kawashimaken/smartknob/electronics/motor_driver_tmc6300/motor_driver_tmc6300.kicad_pcb

## KiCad design electronics/motor_driver_tmc6300/motor_driver_tmc6300.kicad_pcb (2024-10-07)

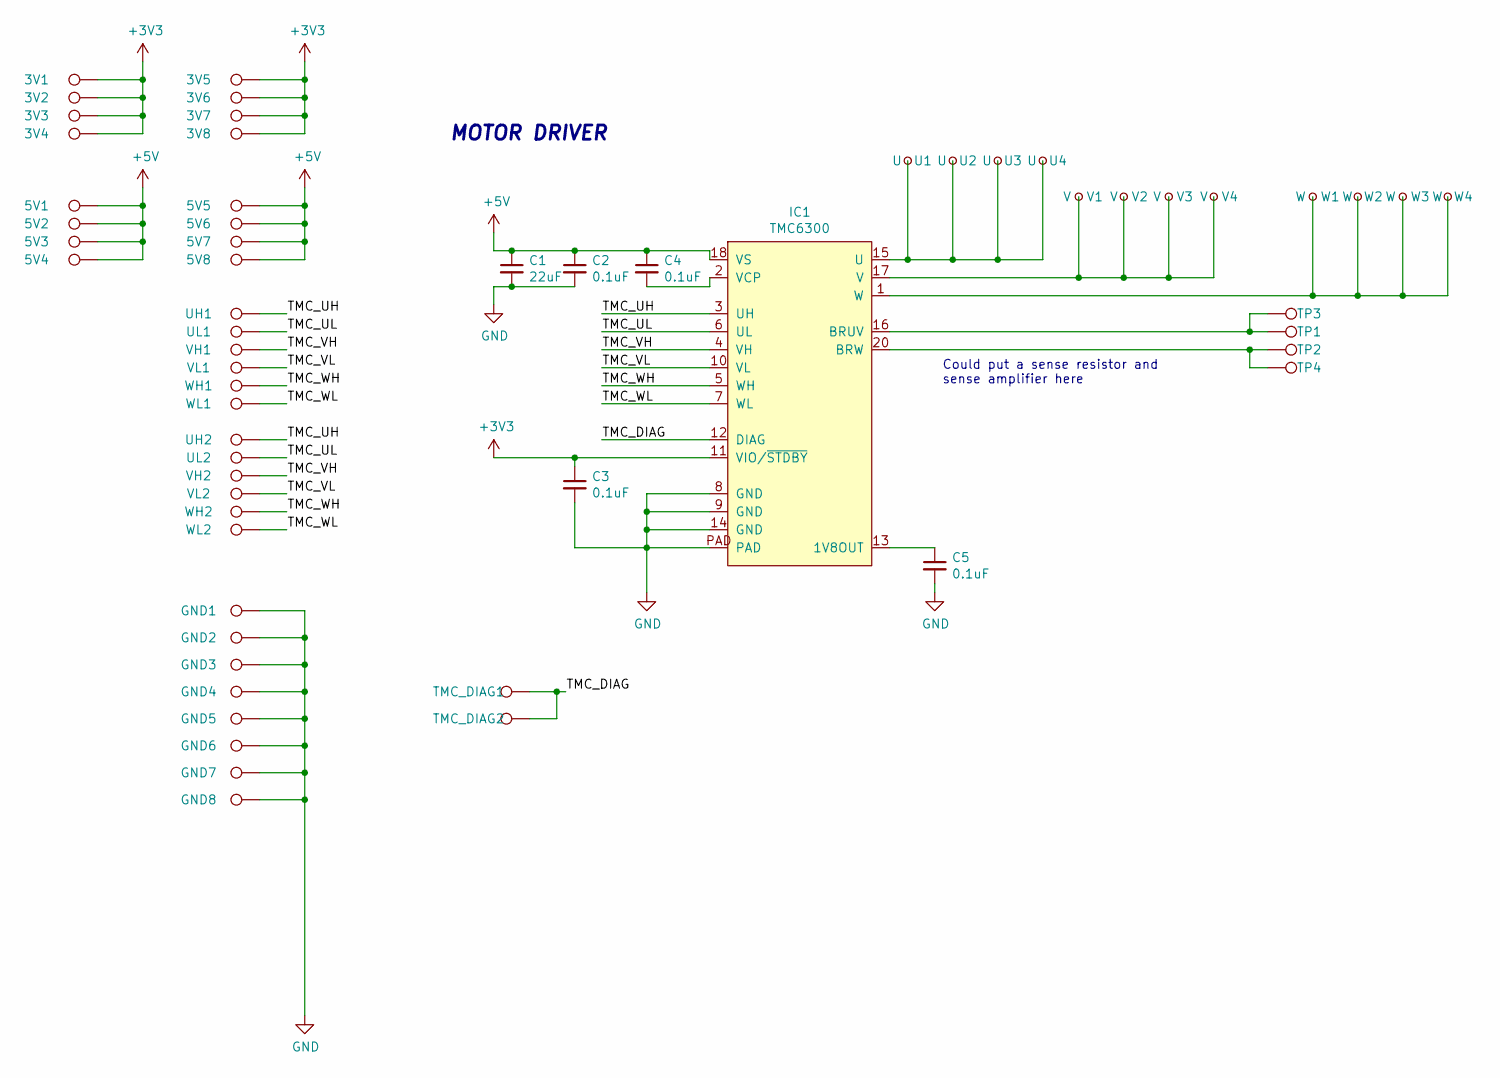
[picture p1: schematic motor_driver_tmc6300.kicad_sch, SmartKnob View]

Parts:
3V1, 3V2, 3V3, 3V4, 3V5, 3V6, 3V7, 3V8, 5V1, 5V2, 5V3, 5V4, 5V5, 5V6, 5V7, 5V8: TestPoint; kawashima_TestPoint_THTPad_D1.5mm_Drill0.7mm
C1: 22uF; C_0805_2012Metric_Pad1.18x1.45mm_HandSolder; LCSC C98190
C2, C3, C4, C5: 0.1uF; C_0603_1608Metric_Pad1.08x0.95mm_HandSolder; LCSC C1591
GND1, GND2, GND3, GND4, GND5, GND6, GND7, GND8: TestPoint; kawashima_TestPoint_THTPad_D1.5mm_Drill0.7mm
IC1: TMC6300; QFN-20-1EP_3x3mm_P0.4mm_EP1.65x1.65mm_ThermalVias_LargerVia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; Digikey TMC6300-LA-T
TMC_DIAG1, TMC_DIAG2: TestPoint; kawashima_TestPoint_THTPad_D1.5mm_Drill0.7mm
TP1, TP2, TP3, TP4: TestPoint; kawashima_TestPoint_THTPad_D1.5mm_Drill0.7mm
U1, U2, U3, U4: U; kawashima_TestPoint_THTPad_D1.5mm_Drill0.7mm
UH1, UH2: TestPoint; kawashima_TestPoint_THTPad_D1.5mm_Drill0.7mm
UL1, UL2: TestPoint; kawashima_TestPoint_THTPad_D1.5mm_Drill0.7mm
V1, V2, V3, V4: V; kawashima_TestPoint_THTPad_D1.5mm_Drill0.7mm
VH1, VH2: TestPoint; kawashima_TestPoint_THTPad_D1.5mm_Drill0.7mm
VL1, VL2: TestPoint; kawashima_TestPoint_THTPad_D1.5mm_Drill0.7mm
W1, W2, W3, W4: W; kawashima_TestPoint_THTPad_D1.5mm_Drill0.7mm
WH1, WH2: TestPoint; kawashima_TestPoint_THTPad_D1.5mm_Drill0.7mm
WL1, WL2: TestPoint; kawashima_TestPoint_THTPad_D1.5mm_Drill0.7mm

Connections:
+3V3: 3V1.1, 3V2.1, 3V3.1, 3V4.1, 3V5.1, 3V6.1, 3V7.1, 3V8.1, C3.1, IC1.11 (VIO/~STDBY)
+5V: 5V1.1, 5V2.1, 5V3.1, 5V4.1, 5V5.1, 5V6.1, 5V7.1, 5V8.1, C1.1, C2.1, C4.1, IC1.18 (VS)
/TMC_DIAG: IC1.12 (DIAG), TMC_DIAG1.1, TMC_DIAG2.1
/TMC_UH: IC1.3 (UH), UH1.1, UH2.1
/TMC_UL: IC1.6 (UL), UL1.1, UL2.1
/TMC_VH: IC1.4 (VH), VH1.1, VH2.1
/TMC_VL: IC1.10 (VL), VL1.1, VL2.1
/TMC_WH: IC1.5 (WH), WH1.1, WH2.1
/TMC_WL: IC1.7 (WL), WL1.1, WL2.1
GND: C1.2, C2.2, C3.2, C5.2, GND1.1, GND2.1, GND3.1, GND4.1, GND5.1, GND6.1, GND7.1, GND8.1, IC1.8 (GND), IC1.9 (GND), IC1.14 (GND), IC1.PAD
unnamed: C5.1, IC1.13 (1V8OUT)
unnamed: IC1.16 (BRUV), TP1.1, TP3.1
unnamed: IC1.20 (BRW), TP2.1, TP4.1
unnamed: IC1.15 (U), U1.1, U2.1, U3.1, U4.1
unnamed: IC1.17 (V), V1.1, V2.1, V3.1, V4.1
unnamed: C4.2, IC1.2 (VCP)
unnamed: IC1.1 (W), W1.1, W2.1, W3.1, W4.1

Notes on the sheet:
Could put a sense resistor and sense amplifier here
MOTOR DRIVER

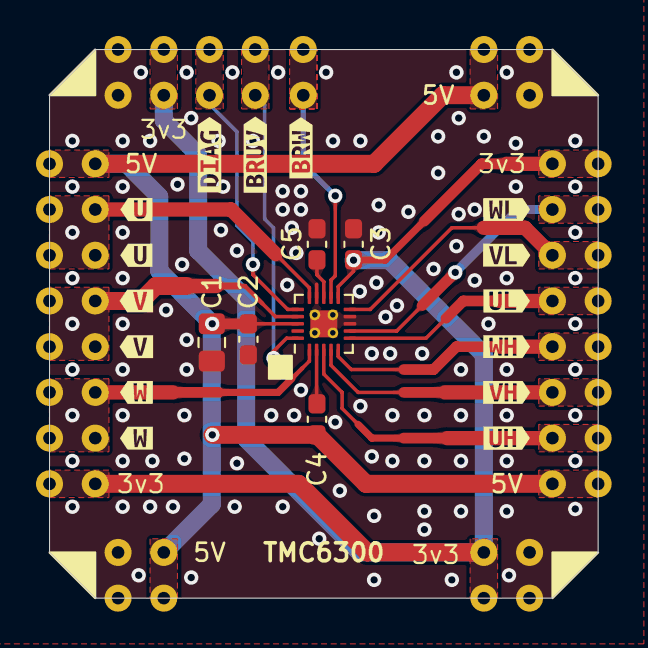
[picture p2: board motor_driver_tmc6300.kicad_pcb from above]

Board: 2 copper layers, 30.5 x 30.5 mm, 75 parts (0 on the bottom side), 17 nets.

Other parts of the board:
kibuzzard-6701E86E, kibuzzard-6701E86E#2: G***; kibuzzard-6701E86E
kibuzzard-6701E87B, kibuzzard-6701E87B#2: G***; kibuzzard-6701E87B
kibuzzard-6701E882, kibuzzard-6701E882#2: G***; kibuzzard-6701E882
kibuzzard-670234D9: G***; kibuzzard-670234D9
kibuzzard-6702202C: G***; kibuzzard-6702202C
kibuzzard-6702204D: G***; kibuzzard-6702204D
kibuzzard-6702206A: G***; kibuzzard-6702206A
kibuzzard-67022038: G***; kibuzzard-67022038
kibuzzard-67022043: G***; kibuzzard-67022043
kibuzzard-67022085: G***; kibuzzard-67022085
kibuzzard-67032619: G***; kibuzzard-67032619
kibuzzard-67032626: G***; kibuzzard-67032626
