kawashimaken/smartknob/electronics/motor_driver_tmc6300/motor_driver_tmc6300-rounded.kicad_pcb

## KiCad design electronics/motor_driver_tmc6300/motor_driver_tmc6300-rounded.kicad_pcb (2024-10-06)

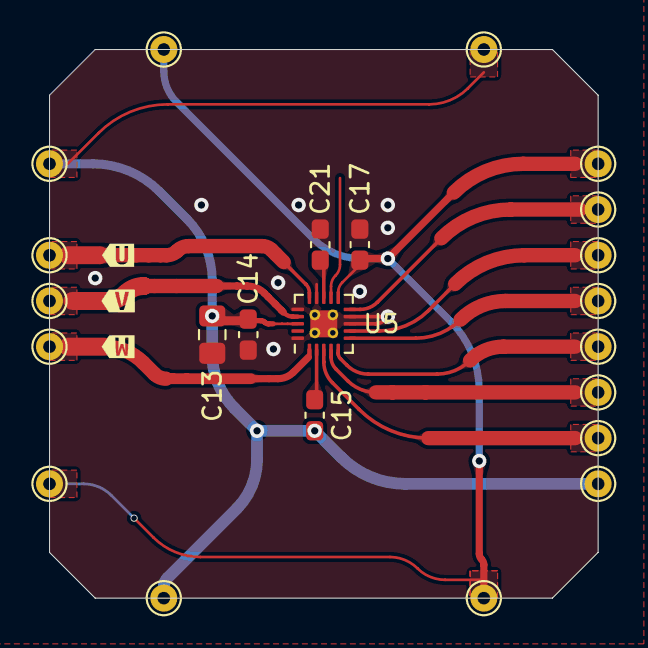
[picture p6: board motor_driver_tmc6300-rounded.kicad_pcb from above]

Board: 2 copper layers, 30.5 x 30.5 mm, 26 parts (0 on the bottom side), 14 nets.

Parts:
3V1, 3V2, 3V3, 3V4, 5V1, 5V2, 5V3, 5V4: TestPoint; TestPoint_THTPad_D1.5mm_Drill0.7mm
C13: 22uF; C_0805_2012Metric_Pad1.18x1.45mm_HandSolder
C14, C15, C17, C21: 0.1uF; C_0603_1608Metric_Pad1.08x0.95mm_HandSolder
U1: U; TestPoint_THTPad_D1.5mm_Drill0.7mm
U5: TMC6300; QFN-20-1EP_3x3mm_P0.4mm_EP1.65x1.65mm_ThermalVias_LargerVia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
UH1: TestPoint; TestPoint_THTPad_D1.5mm_Drill0.7mm
UL1: TestPoint; TestPoint_THTPad_D1.5mm_Drill0.7mm
V1: V; TestPoint_THTPad_D1.5mm_Drill0.7mm
VH1: TestPoint; TestPoint_THTPad_D1.5mm_Drill0.7mm
VL1: TestPoint; TestPoint_THTPad_D1.5mm_Drill0.7mm
W1: W; TestPoint_THTPad_D1.5mm_Drill0.7mm
WH1: TestPoint; TestPoint_THTPad_D1.5mm_Drill0.7mm
WL1: TestPoint; TestPoint_THTPad_D1.5mm_Drill0.7mm
kibuzzard-6701E86E: G***; kibuzzard-6701E86E
kibuzzard-6701E87B: G***; kibuzzard-6701E87B
kibuzzard-6701E882: G***; kibuzzard-6701E882

Connections:
+3V3: 3V1.1, 3V2.1, 3V3.1, 3V4.1, C17.1, U5.11 (VIO/~STDBY)
+5V: 5V1.1, 5V2.1, 5V3.1, 5V4.1, C13.1, C14.1, C15.1, U5.18 (VS)
/TMC_UH: U5.3 (UH), UH1.1
/TMC_UL: U5.6 (UL), UL1.1
/TMC_VH: U5.4 (VH), VH1.1
/TMC_VL: U5.10 (VL), VL1.1
/TMC_WH: U5.5 (WH), WH1.1
/TMC_WL: U5.7 (WL), WL1.1
GND: C13.2, C14.2, C17.2, C21.2, U5.8 (GND), U5.9 (GND), U5.14 (GND), U5.16 (BRUV), U5.20 (BRW), U5.PAD
unnamed: C21.1, U5.13 (1V8OUT)
unnamed: U1.1, U5.15 (U)
unnamed: U5.17 (V), V1.1
unnamed: C15.2, U5.2 (VCP)
unnamed: U5.1 (W), W1.1
