kawashimaken/smartknob/(commit log)

2024-06-30 add view_base_new
    [view_base_new.kicad_pcb, view_base_new.kicad_sch]
2024-06-30 improve routing
    [view_base_new.kicad_pcb, view_base_new.kicad_sch]
2024-07-02 tuning routing, save work
    [view_base_new.kicad_pcb, view_base_new.kicad_sch]
2024-07-02 change to hand soldering pad
    [view_base_new.kicad_pcb, view_base_new.kicad_sch]
2024-10-06 add tmc6300 motor driver board
    [motor_driver_tmc6300-rounded.kicad_pcb, motor_driver_tmc6300.kicad_pcb, motor_driver_tmc6300.kicad_sch, view_base_esp32_s3.kicad_pcb, view_base_esp32_s3.kicad_sch]
